NT7S/Si5351AVFO/enclosure/renders/vfo_case_connectors.png

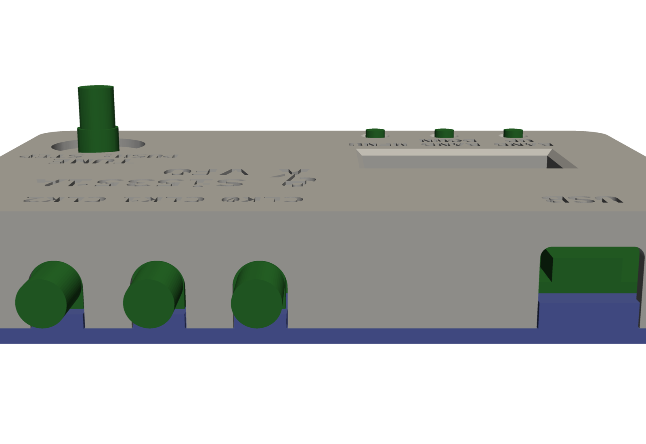
enclosure/renders/vfo_case_connectors.png
