NT7S/Si5351AVFO/enclosure/renders/vfo_case_labels2_front.png

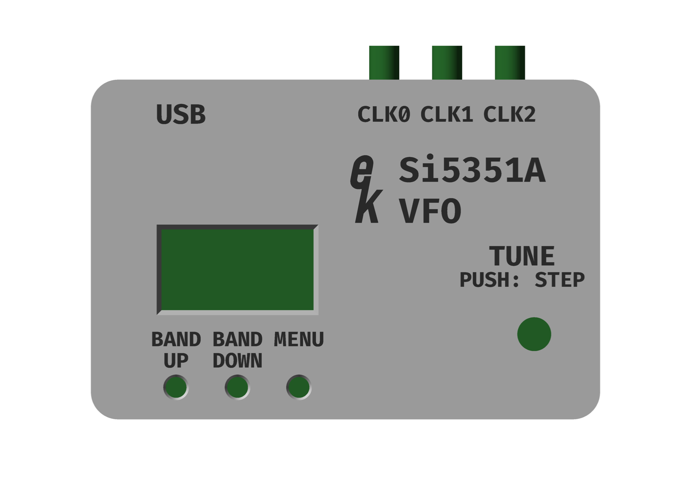
enclosure/renders/vfo_case_labels2_front.png
