NT7S/Si5351AVFO/tools/oledsim/renders/after/main_superhet.png

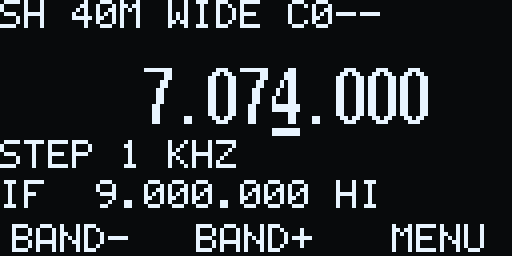
tools/oledsim/renders/after/main_superhet.png
