NT7S/Si5351AVFO/tools/oledsim/renders/after/save_cal.png

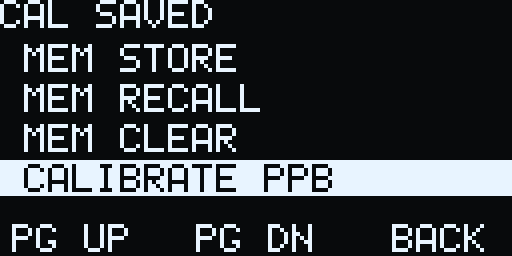
tools/oledsim/renders/after/save_cal.png
