NT7S/Si5351AVFO/tools/oledsim/renders/after/save_filter.png

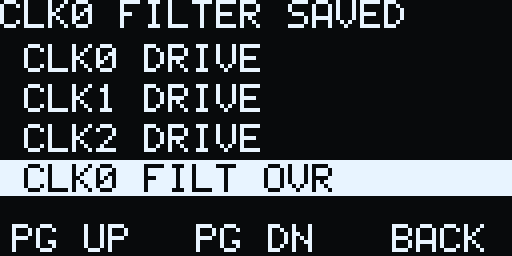
tools/oledsim/renders/after/save_filter.png
