NT7S/Si5351AVFO/tools/oledsim/renders/after/save_inject.png

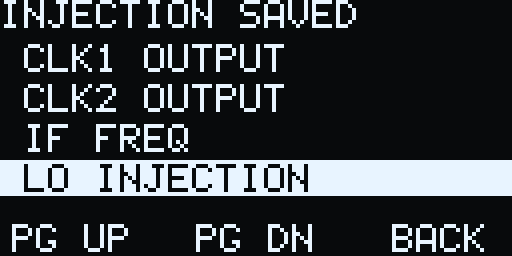
tools/oledsim/renders/after/save_inject.png
