NT7S/Si5351AVFO/tools/oledsim/renders/before/menu_pos_10.png

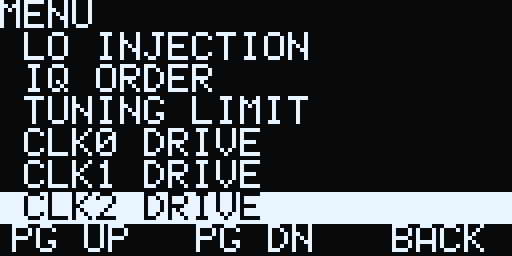
tools/oledsim/renders/before/menu_pos_10.png
