NT7S/Si5351AVFO/tools/oledsim/renders/before/save_clk.png

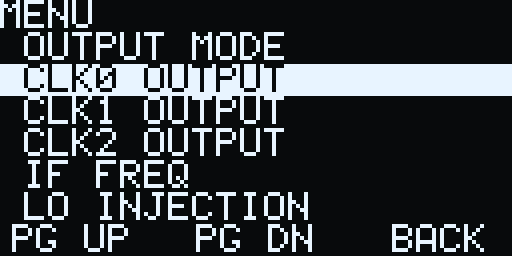
tools/oledsim/renders/before/save_clk.png
