NT7S/Si5351AVFO/tools/oledsim/renders/before/save_drive.png

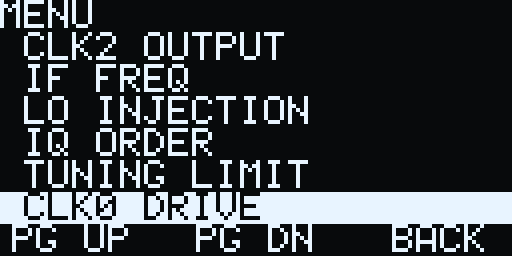
tools/oledsim/renders/before/save_drive.png
