NT7S/Si5351AVFO/tools/oledsim/renders/before/save_filter.png

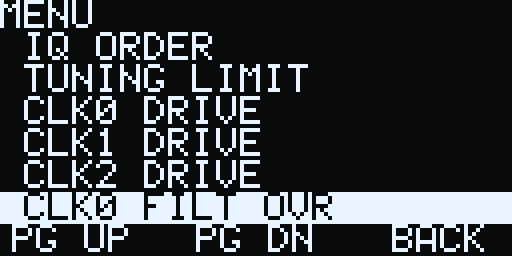
tools/oledsim/renders/before/save_filter.png
