NT7S/Si5351AVFO/tools/oledsim/renders/before/save_if.png

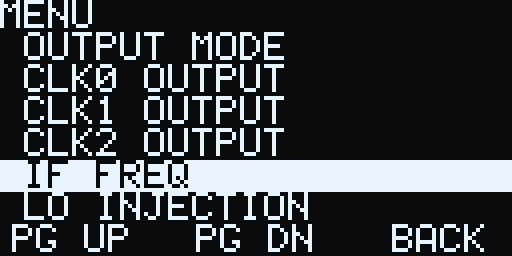
tools/oledsim/renders/before/save_if.png
