NT7S/Si5351AVFO/tools/oledsim/renders/before/save_memory.png

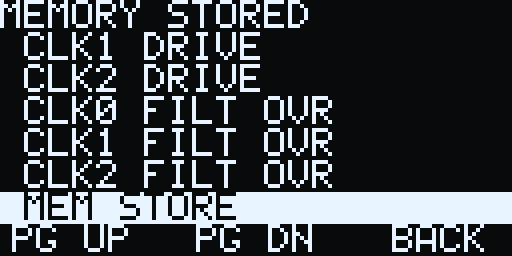
tools/oledsim/renders/before/save_memory.png
