NT7S/Si5351AVFO/tools/oledsim/renders/before/save_mode.png

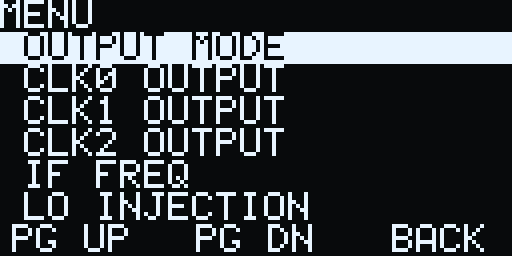
tools/oledsim/renders/before/save_mode.png
