NT7S/Si5351AVFO/tools/oledsim/renders/contact.png

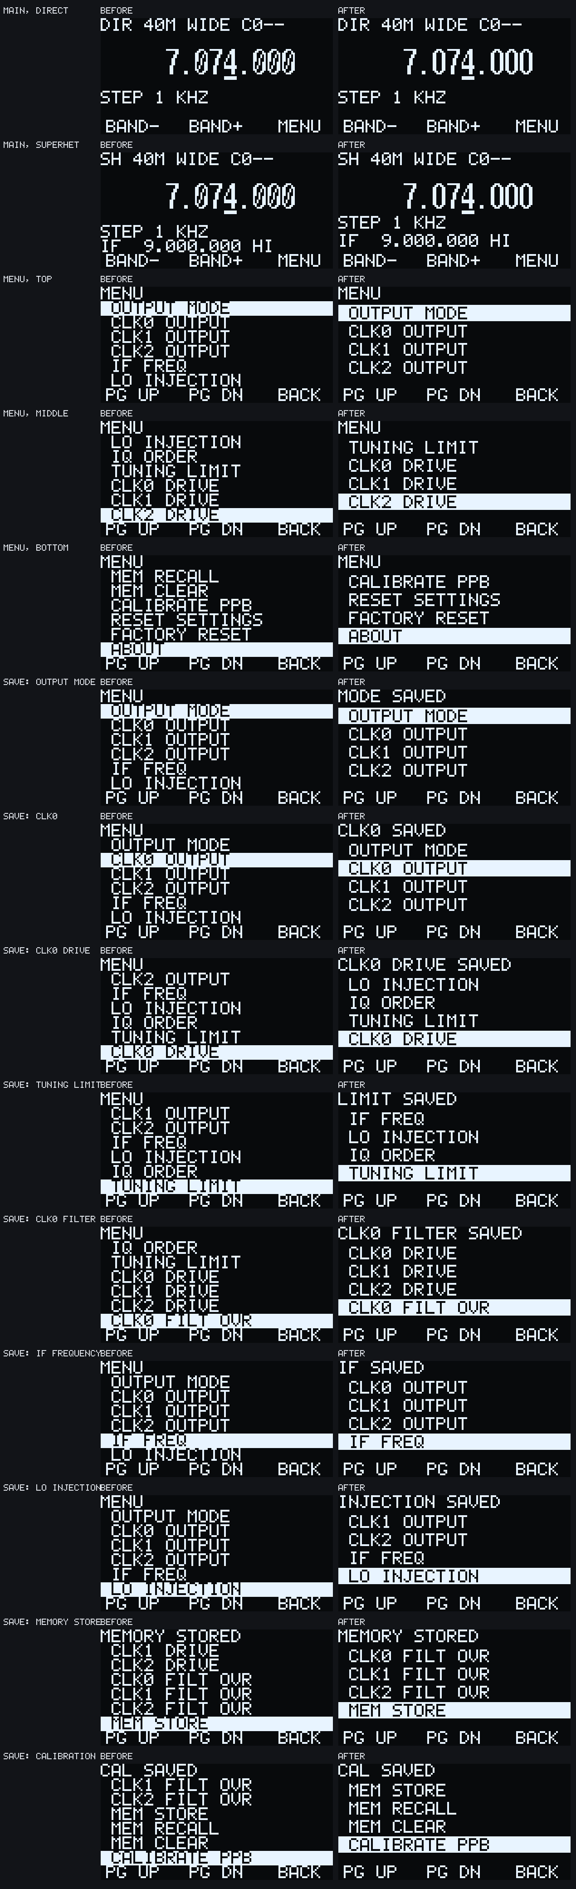
tools/oledsim/renders/contact.png
