NT7S/Si5351AVFO/PCB/production/Si5351AVFO_BOM_JLC.csv

Comment | Designator | Footprint | LCSC Part #
1u | C1,C7 | C_0805_2012Metric | C28323
100n | C2,C4-C6,C8,C14,C15,C17-C21,C25,C28,C100,C120,C140 | C_0805_2012Metric | C49678
4.7u | C3,C9,C16,C22,C23 | C_0805_2012Metric | C1779
100n | C10,C13 | C_0603_1608Metric | C14663
4.7u | C11,C12 | C_0603_1608Metric | C19666
22u | C24 | C_1206_3216Metric | C12891
100n | C26 | C_0402_1005Metric | C1525
10u | C27 | C_0805_2012Metric | C15850
33p | C101,C121 | C_0603_1608Metric | C519485
75p | C102,C122 | C_0603_1608Metric | C519496
82p | C103,C123 | C_0603_1608Metric | C519487
43p | C104,C124 | C_0603_1608Metric | C519493
39p | C105,C125 | C_0603_1608Metric | C527048
20p | C106,C126 | C_0603_1608Metric | C326779
9.1p | C107,C127 | C_0603_1608Metric | C513588
3.6p | C141 | C_0603_1608Metric | C519106
24p | C142 | C_0603_1608Metric | C2857979
30p | C143 | C_0603_1608Metric | C519491
18p | C144 | C_0603_1608Metric | C527046
16p | C145 | C_0603_1608Metric | C519489
5.6p | C146 | C_0603_1608Metric | C519111
2.0p | C147 | C_0603_1608Metric | C513620
SP0503BAHT | D1 | SOT-143 | C7074
1N5711W | D4 | D_SOD-123 | C154843
BLM18PG221 | FB1,FB2 | L_0603_1608Metric | C80165
USB_C_Receptacle | J1 | USB_C_Receptacle_HCTL_HC-TYPE-C-16P-01A | C2894897
UPDI | J5 | PinHeader_1x04_P2.54mm_Vertical | C124378
100n | L1,L4 | L_1008_2520Metric | C1330579
150n | L2,L3,L5,L6 | L_1008_2520Metric | C2044861
33n | L7 | L_1008_2520Metric | C2043161
68n | L8,L9 | L_1008_2520Metric | C703709
5.1k | R1,R2 | R_0603_1608Metric | C23186
10 | R5 | R_0805_2012Metric | C17415
22.1k | R7 | R_0603_1608Metric | C137768
47.5k | R8 | R_0603_1608Metric | C2933225
1k | R9,R29 | R_0603_1608Metric | C21190
10k | R12,R14-R19,R21-R25 | R_0805_2012Metric | C17414
470 | R13 | R_0603_1608Metric | C23179
4.7k | R27,R28 | R_0805_2012Metric | C17673
0 | R100,R120,R140 | R_0402_1005Metric | C17168
EC11E18244A5 | SW1 | RotaryEncoder_Alps_EC11E-Switch_Vertical_H20mm | C255515
SOFT1 | SW2 | SW_Push_6x6mm_SMD_KH-6X6X11H-STM | C2837537
SOFT2 | SW3 | SW_Push_6x6mm_SMD_KH-6X6X11H-STM | C2837537
SOFT3 | SW4 | SW_Push_6x6mm_SMD_KH-6X6X11H-STM | C2837537
LP2985-3.3 | U1,U5 | SOT-23-5 | C16085
Si5351A-B-GT | U2 | MSOP-10_3x3mm_P0.5mm | C529366
CP2102N-A02-GQFN24 | U3 | QFN-24-1EP_4x4mm_P0.5mm_EP2.6x2.6mm | C969151
ATtiny3226-SU | U4 | SOIC-20W_7.5x12.8mm_P1.27mm | C3234898
25MHz TCXO | X1 | Oscillator_SMD_SeikoEpson_SG8002CE-4Pin_3.2x2.5mm | C48888230
