NT7S/Si5351AVFO/enclosure/step/vfo_front_shell_assembly_frame.step

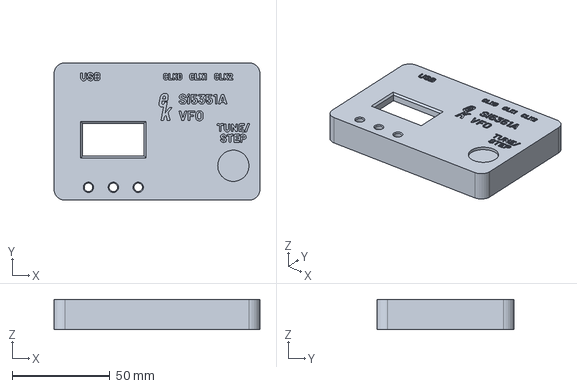
[picture p15: CAD file, 2026-10-25]
enclosure/step/vfo_front_shell_assembly_frame.step
105.2 x 70.2 x 15.4 mm
