NT7S/Si5351AVFO/enclosure/3mf/VFO_case_2color_PETG_CC2_rev4.3mf

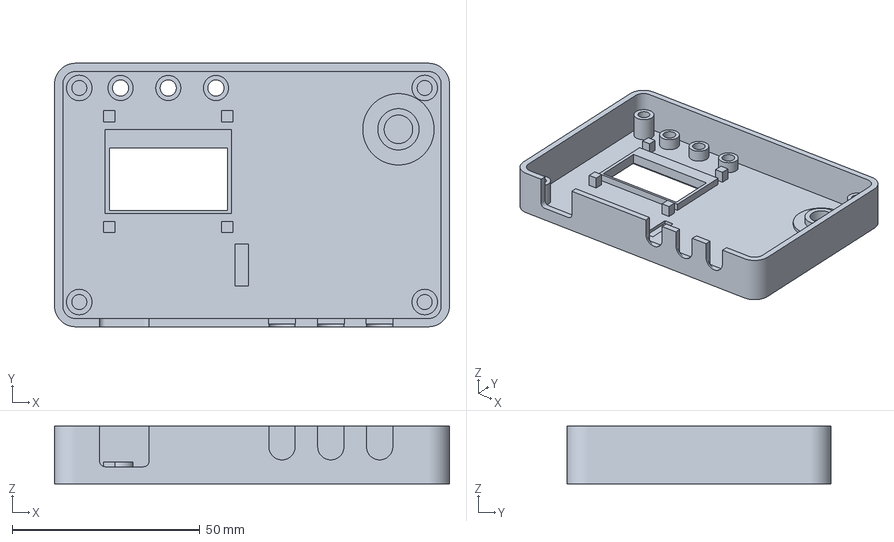
[picture p16: CAD file, 2026-10-25]
enclosure/3mf/VFO_case_2color_PETG_CC2_rev4.3mf
105.2 x 70.2 x 15.4 mm
