NT7S/Si5351AVFO/enclosure/stl/vfo_front_shell_inlay.stl

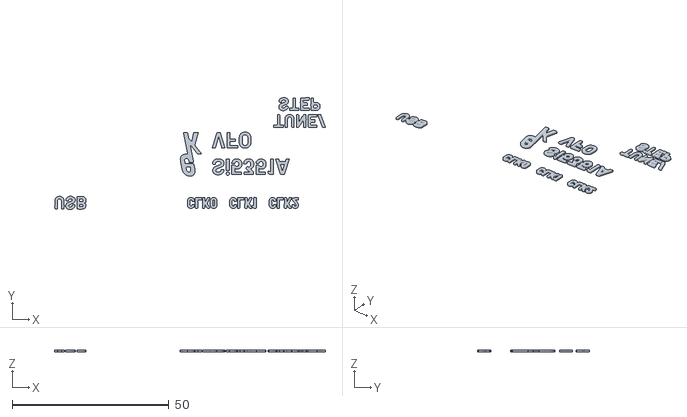
[picture p17: CAD file, 2026-10-25]
enclosure/stl/vfo_front_shell_inlay.stl
86.3 x 35.8 x 0.6
