NT7S/Si5351AVFO/(list of files, cad)

Other CAD files:
enclosure/step/vfo_front_shell_2color.step
enclosure/stl/vfo_front_shell_body.stl
enclosure/step/vfo_front_shell.step
