NT7S/Si5351AVFO/enclosure/renders/vfo_case_cover_print.png

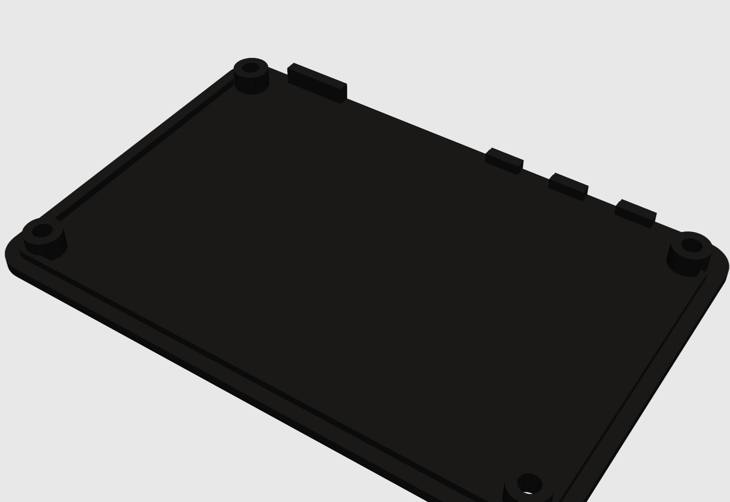
enclosure/renders/vfo_case_cover_print.png
