NT7S/Si5351AVFO/PCB/Si5351AVFO.kicad_pcb

## KiCad design PCB/Si5351AVFO.kicad_pcb (2026-10-28)

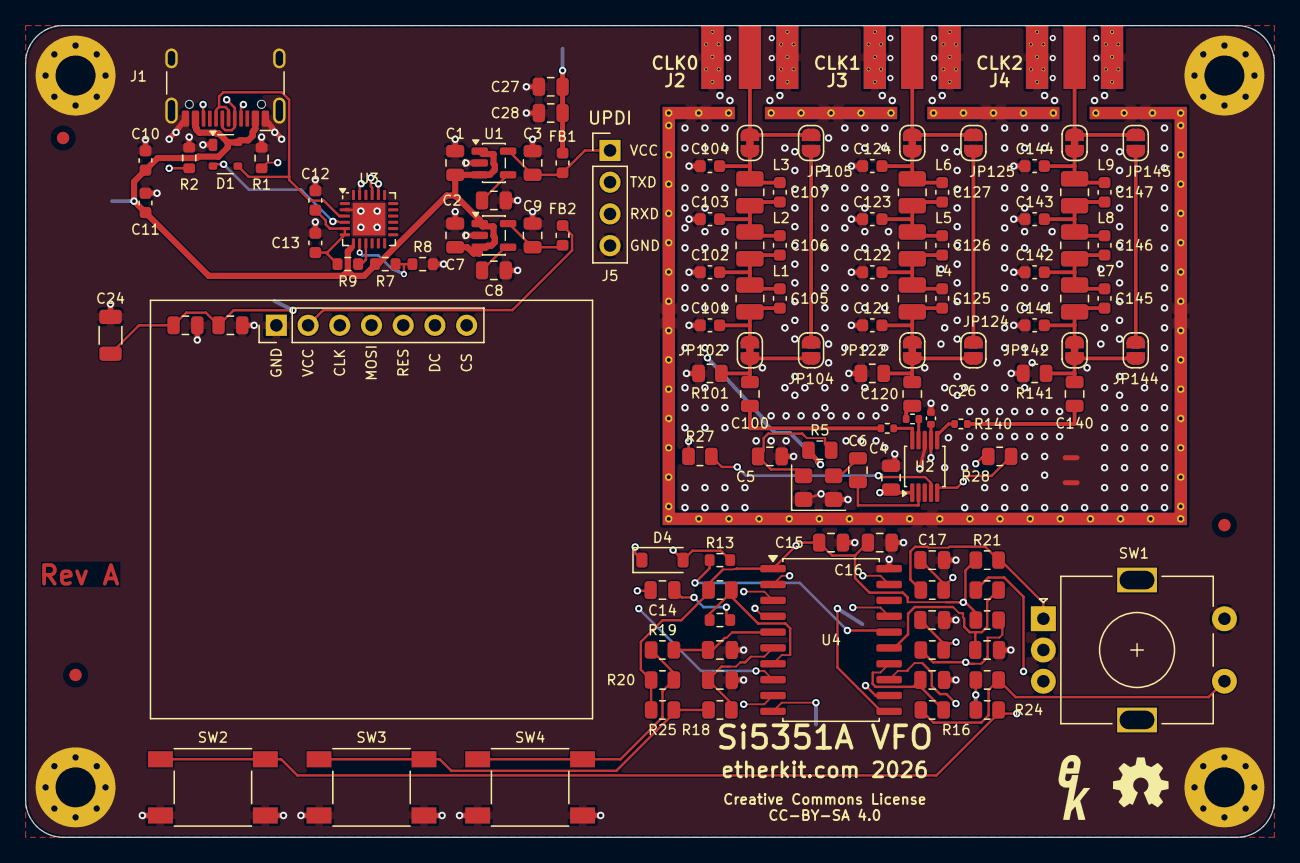
[picture p24: board Si5351AVFO.kicad_pcb from above]

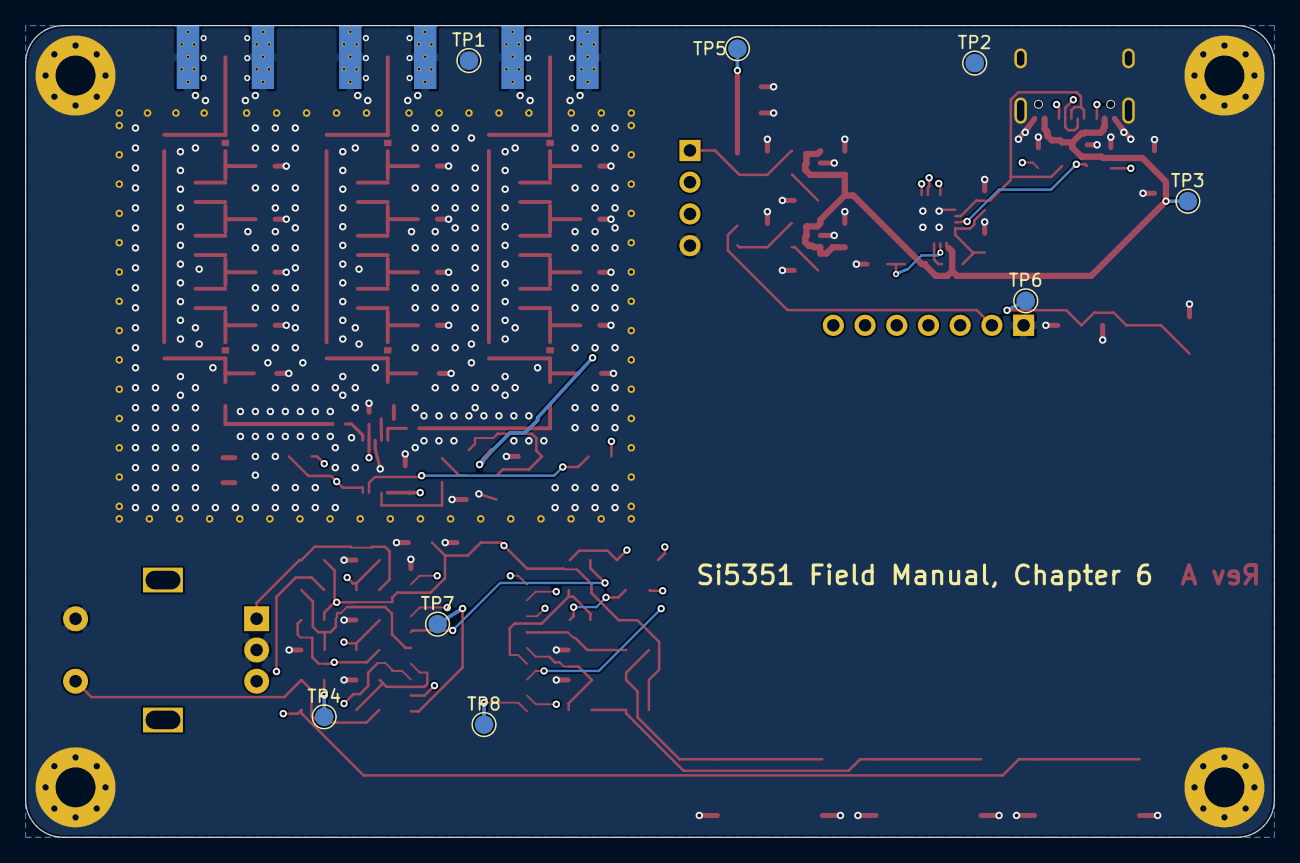
[picture p25: board Si5351AVFO.kicad_pcb from below]

Board: 4 copper layers, 100.0 x 65.0 mm, 140 parts (8 on the bottom side), 72 nets.

Parts:
C1, C7: 1u; C_0805_2012Metric
C2, C4, C5, C6, C8, C14, C15, C17, C18, C19, C20, C21, C25, C28, C100, C120, C140: 100n; C_0805_2012Metric
C3, C9, C16, C22, C23: 4.7u; C_0805_2012Metric
C10, C13: 100n; C_0603_1608Metric
C11, C12: 4.7u; C_0603_1608Metric
C24: 22u; C_1206_3216Metric
C26: 100n; C_0402_1005Metric
C27: 10u; C_0805_2012Metric
C101, C121: 33p; C_0603_1608Metric
C102, C122: 75p; C_0603_1608Metric
C103, C123: 82p; C_0603_1608Metric
C104, C124: 43p; C_0603_1608Metric
C105, C125: 39p; C_0603_1608Metric
C106, C126: 20p; C_0603_1608Metric
C107, C127: 9.1p; C_0603_1608Metric
C141: 3.6p; C_0603_1608Metric
C142: 24p; C_0603_1608Metric
C143: 30p; C_0603_1608Metric
C144: 18p; C_0603_1608Metric
C145: 16p; C_0603_1608Metric
C146: 5.6p; C_0603_1608Metric
C147: 2.0p; C_0603_1608Metric
D1: SP0503BAHT; SOT-143
D4: 1N5711W; D_SOD-123
DS1: OLED_1.3in_SH1106_SPI_7pin; PinHeader_1x07_P2.54mm_Vertical
FB1, FB2: BLM18PG221; L_0603_1608Metric
FID1, FID2, FID3: Fiducial; Fiducial_1mm_Mask2mm
H1, H2, H3, H4: M3; MountingHole_3.2mm_M3_Pad_Via
J1: USB_C_Receptacle; USB_C_Receptacle_HCTL_HC-TYPE-C-16P-01A
J2: SMA CLK0; SMA-ENDLAUNCH
J3: SMA CLK1; SMA-ENDLAUNCH
J4: SMA CLK2; SMA-ENDLAUNCH
J5: UPDI; PinHeader_1x04_P2.54mm_Vertical
JP102, JP103, JP122, JP123, JP142, JP143: NC; SolderJumper-2_P1.3mm_Bridged_RoundedPad1.0x1.5mm
JP104, JP105, JP124, JP125, JP144, JP145: NO; SolderJumper-2_P1.3mm_Open_RoundedPad1.0x1.5mm
L1, L4: 100n; L_1008_2520Metric
L2, L3, L5, L6: 150n; L_1008_2520Metric
L7: 33n; L_1008_2520Metric
L8, L9: 68n; L_1008_2520Metric
LOGO1: Val**; EtherkitLogoSmall
LOGO2: Logo_Open_Hardware_Small; OSHWLogo4mm
R1, R2: 5.1k; R_0603_1608Metric
R5: 10; R_0805_2012Metric
R7: 22.1k; R_0603_1608Metric
R8: 47.5k; R_0603_1608Metric
R9, R29: 1k; R_0603_1608Metric
R12, R14, R15, R16, R17, R18, R19, R20, R21, R22, R23, R24, R25: 10k; R_0805_2012Metric
R13: 470; R_0603_1608Metric
R27, R28: 4.7k; R_0805_2012Metric
R100, R120, R140: 0; R_0402_1005Metric
R101, R121, R141: 120; R_0805_2012Metric
SH1: RF_FENCE; RF_Fence_42x33.5mm
SW1: EC11E18244A5; RotaryEncoder_Alps_EC11E-Switch_Vertical_H20mm
SW2: SOFT1; SW_Push_6x6mm_SMD_KH-6X6X11H-STM
SW3: SOFT2; SW_Push_6x6mm_SMD_KH-6X6X11H-STM
SW4: SOFT3; SW_Push_6x6mm_SMD_KH-6X6X11H-STM
TP1, TP2: GND; TestPoint_Pad_D1.5mm
TP3: +5V; TestPoint_Pad_D1.5mm
TP4: +3V3D; TestPoint_Pad_D1.5mm
TP5: +3V3_CLK; TestPoint_Pad_D1.5mm
TP6: +3V3_OLED; TestPoint_Pad_D1.5mm
TP7: I2C_SCL; TestPoint_Pad_D1.5mm
TP8: I2C_SDA; TestPoint_Pad_D1.5mm
U1, U5: LP2985-3.3; SOT-23-5
U2: Si5351A-B-GT; MSOP-10_3x3mm_P0.5mm
U3: CP2102N-A02-GQFN24; QFN-24-1EP_4x4mm_P0.5mm_EP2.6x2.6mm
U4: ATtiny3226-SU; SOIC-20W_7.5x12.8mm_P1.27mm
X1: 25MHz TCXO; Oscillator_SMD_SeikoEpson_SG8002CE-4Pin_3.2x2.5mm

Connections:
+3V3D: C3.1, C15.1, C16.1, FB1.1, J5.1, R12.1, R20.1, R21.1, R22.1, R23.1, R24.1, R25.1, R27.1, R28.1, TP4.1, U1.5, U4.1
+3V3_CLK: C4.1, C26.1, C27.1, C28.1, FB1.2, R5.1, TP5.1, U2.1, U2.7
+3V3_OLED: C22.1, C23.1, C24.1, DS1.2, FB2.2, TP6.1
+5V: C1.1, C7.1, C10.1, C11.1, D1.4, J1.A4, J1.A9, J1.B4, J1.B9, R7.1, TP3.1, U1.1, U1.3, U3.7, U5.1, U5.3
/MCU and UI/BTN_S1: C20.1, R17.2, U4.15
/MCU and UI/BTN_S1_SW: R17.1, R24.2, SW2.1
/MCU and UI/BTN_S2: C21.1, R18.2, U4.6
/MCU and UI/BTN_S2_SW: R18.1, R25.2, SW3.1
/MCU and UI/BTN_S3: C25.1, R19.2, U4.5
/MCU and UI/BTN_S3_SW: R19.1, R20.2, SW4.1
/MCU and UI/ENC_A: C17.1, R14.2, U4.12
/MCU and UI/ENC_A_SW: R14.1, R21.2, SW1.A
/MCU and UI/ENC_B: C18.1, R15.2, U4.13
/MCU and UI/ENC_B_SW: R15.1, R22.2, SW1.B
/MCU and UI/ENC_SW: C19.1, R16.2, U4.14
/MCU and UI/ENC_SW_SW: R16.1, R23.2, SW1.S1
/MCU and UI/OLED_CS: DS1.7, U4.2
/MCU and UI/OLED_DC: DS1.6, U4.3
/MCU and UI/OLED_MOSI: DS1.4, U4.17
/MCU and UI/OLED_RES: DS1.5, U4.4
/MCU and UI/OLED_SCK: DS1.3, U4.19
/MCU and UI/UPDI_PA0: R13.1, U4.16
/MCU and UI/UPDI_TXD: D4.1, J5.2
/Power and USB/CP_RST: R9.2, U3.9
/Power and USB/CP_VBUS_SENSE: R7.2, R8.1, U3.8
/Power and USB/CP_VDD: C12.1, C13.1, R9.1, U3.5, U3.6
/Power and USB/USB_DM: D1.2, J1.A7, J1.B7, U3.4
/Power and USB/USB_DP: D1.3, J1.A6, J1.B6, U3.3
/Synth and RF outputs/CLK0: R100.1, U2.10
/Synth and RF outputs/CLK0_BYP: JP104.2, JP105.1
/Synth and RF outputs/CLK1: R120.1, U2.9
/Synth and RF outputs/CLK1_BYP: JP124.2, JP125.1
/Synth and RF outputs/CLK2: R140.1, U2.6
/Synth and RF outputs/CLK2_BYP: JP144.2, JP145.1
DTR: C14.1, U3.23
GND: C1.2, C2.2, C3.2, C4.2, C5.2, C7.2, C8.2, C9.2, C10.2, C11.2, C12.2, C13.2, C15.2, C16.2, C17.2, C18.2, C19.2, C20.2, C21.2, C22.2, C23.2, C24.2, C25.2, C26.2, C27.2, C28.2, C101.2, C102.2, C103.2, C104.2, C121.2, C122.2, C123.2, C124.2, C141.2, C142.2, C143.2, C144.2, D1.1, DS1.1, H1.1, H2.1, H3.1, H4.1, J1.A1, J1.A12, J1.B1, J1.B12, J1.SH, J2.2, J3.2, J4.2, J5.4, R1.2, R2.2, R8.2, R101.2, R121.2, R141.2, SH1.1, SW1.C, SW1.S2, SW2.2, SW3.2, SW4.2, TP1.1, TP2.1, U1.2, U2.8, U3.2, U3.25, U4.20, U5.2, X1.1, X1.2
I2C_SCL: R27.2, TP7.1, U2.4, U4.11
I2C_SDA: R28.2, TP8.1, U2.5, U4.10
MCU_RX: U3.21, U4.8
MCU_TX: U3.20, U4.9
unnamed: C14.2, R29.2
unnamed: C100.1, R100.2
unnamed: C102.1, C105.2, C106.1, L1.2, L2.1
unnamed: C103.1, C106.2, C107.1, L2.2, L3.1
unnamed: C120.1, R120.2
unnamed: C122.1, C125.2, C126.1, L4.2, L5.1
unnamed: C123.1, C126.2, C127.1, L5.2, L6.1
unnamed: C140.1, R140.2
unnamed: C142.1, C145.2, C146.1, L7.2, L8.1
unnamed: C143.1, C146.2, C147.1, L8.2, L9.1
unnamed: D4.2, J5.3, R13.2
unnamed: J1.A5, R1.1
unnamed: J1.B5, R2.1
unnamed: J2.1, JP103.2, JP105.2
unnamed: J3.1, JP123.2, JP125.2
unnamed: J4.1, JP143.2, JP145.2
unnamed: C100.2, JP102.1, JP104.1, R101.1
unnamed: C101.1, C105.1, JP102.2, L1.1
unnamed: C104.1, C107.2, JP103.1, L3.2
unnamed: C120.2, JP122.1, JP124.1, R121.1
unnamed: C121.1, C125.1, JP122.2, L4.1
unnamed: C124.1, C127.2, JP123.1, L6.2
unnamed: C140.2, JP142.1, JP144.1, R141.1
unnamed: C141.1, C145.1, JP142.2, L7.1
unnamed: C144.1, C147.2, JP143.1, L9.2
unnamed: C2.1, U1.4
unnamed: C6.2, U2.2
unnamed: R12.2, R29.1, U4.7
unnamed: C8.1, U5.4
unnamed: C9.1, FB2.1, U5.5
unnamed: C6.1, X1.3
unnamed: C5.1, R5.2, X1.4
