NT7S/Si5351AVFO/(commit log)

2026-10-23 Rev A schematic draft: hierarchical sheets (power/USB, MCU/UI, synth/RF), ERC clean, VERIFY list
2026-10-23 UPDI: replicate EtherKeyerMini UPDI circuit (J5/R13/D4/D5/JP1/JP2); remove CP2102N LEDs D2/D3 + R10/R11, NC pins 13/14
2026-10-23 Wire local connections (labels only for long/cross-sheet runs); +3V3_MCU diode-OR rail (D6/D5); drop UPDI JP1/JP2; fix C14 fields
2026-10-23 Drop +3V3_MCU/D5/D6: U4 and pull-ups back on +3V3D; J5 pin 1 = +3V3D VCC reference (USB-powered programming)
2026-10-23 synth_rf: populate Cauer LPFs (CLK0/1 60 MHz, CLK2 160 MHz) with LCSC parts; replace 0R filter links with solder jumpers (JP1x2/JP1x3 NC in-line, JP1x4 NO bypass); interchangeability note
2026-10-24 Schematic: US resistor symbols, decoupling caps at their ICs, drop finalized VERIFY notes
    - Device:R_Small -> Device:R_Small_US on all 30 resistors (same pin geometry; refs/values/fields/footprints/LCSC unchanged)
    - Move label-connected decoupling caps next to their ICs: C10/C11 + C12/C13 at U3, C15/C16 at U4, C4 at U2
    - Add PCB placement notes by U1, U5, U3, U4, U2/X1 and DS1 (pins from netlist)
    - Remove VERIFY note lines and VERIFY fields for items Jason finalized:
    J1 D1 C10 U3 FB2 DS1 C17 SW1 X1 C100 R101 L1 C105
    - Netlist identical to 4963a6d; ERC 0 errors
2026-10-24 Add KiCad .gitignore, untrack lock/autosave/backup files, add tools/export_docs.sh, regenerate docs
2026-10-24 Add GitHub Action: ERC (fail on errors) and auto-regenerate docs on schematic changes
2026-10-24 docs: regenerate schematic PDF, netlist, SVGs, ERC report [skip ci]
2026-10-24 CI: use kicad/kicad:10.0-full (stock libs) and ignore netlist source path
2026-10-24 CI: install default KiCad lib tables so stock libraries resolve
2026-10-24 Resolve VERIFY directives: R9 to VIO, R29 on PB4, OLED bulk, SMD UPDI parts, 4.7k I2C, 0805 0R, Etherkit SMA footprint
    - R9 /RST pull-up moved from +5V to CP_VDD (CP2102N DS 2.1, Table 3.10)
    - New R29 1k (C21190) between C14 and PB4 to limit DTR-rise injection current (ATtiny3226 DS Table 33-1)
    - C24 fitted 22u 1206 (C12891); C22/C23 kept 2x4.7u
    - R13 0603 C23179, D4 1N5711W SOD-123 C154843, J5 1x4 pin header C124378
    - R27/R28 4.7k C17673; R100/R120/R140 0805 0R C17477; R101/R121/R141 LCSC C17437 (DNP)
    - J2-J4 footprint EtherkitKicadLibrary:SMA-ENDLAUNCH
    - H1-H4 and solder jumpers excluded from BOM
    - Finalized VERIFY notes removed from sheets; VERIFY.md items ticked with KiCad EE notes
2026-10-24 docs: regenerate schematic PDF, netlist, SVGs, ERC report
2026-10-24 DS1 OLED: DNP user-fitted (partial kit), no LCSC, off BOM/pos; keep 3.3V LP2985 rail; silkscreen pin-name note; VERIFY DS1 supply resolved; regen docs
2026-10-24 DS1: generic 1.3in SH1106 SPI 7-pin (GND,VCC,CLK,MOSI,RES,DC,CS); OLED_RES on PA6, PA2 freed; remove R26/FS0/CS2; DNP supplied in kit; VERIFY + regen docs
2026-10-24 Retire schgen generator (kicad_sch files are master); drop unverified Adafruit note
2026-10-24 J2-J4 SMA: DNP, supplied in kit, user-soldered; off BOM/pos, LCSC cleared, MPN kept; VERIFY + regen docs
2026-10-24 PCB phase 1: footprints from schematic, JLC04161H-7628 4-layer stackup (blue mask), RF50 netclass 0.35 mm, 100x65 outline + 4x M3, edge/panel part placement, OLED keepout, rough placement (unrouted);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
2026-10-24 SW2-SW4: 6x6 mm 11 mm-tall SMD tact switch KH-6X6X11H-STM (C2837537) for front panel
2026-10-24 H1-H4: plated M3 mounting holes (MountingHole_3.2mm_M3_Pad_Via) tied to GND
2026-10-24 SH1: DNP RF shield solder fence (GND), OSHW logo footprint
2026-10-24 Layout rev 2: USB-C + SMAs on top edge, RF block under SH1 fence, 11 mm tact switches, plated GND M3 holes, In1 cut under SMA centre pads, In1/In2 GND planes, Etherkit branding + Rev A on F.Cu; regen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
2026-10-24 Layout: buttons back in a row under OLED (OLED moved up), Si5351 decoupling at U2/X1 pins, power/USB tidied (LDO rows Cin-U-Cout-FB), CLK0-2 labels, horizontal front branding, back-silk book line, si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
2026-10-24 Layout: straight-line LPF per channel (in-select -> 3-section Cauer ladder -> out-select -> SMA), bypass jumper at input end behind GND via fence; J5 UPDI title + pin labels
2026-10-24 Route RF: CLK0-2 0.35 mm CPWG (gap 0.20) through series R, DC block, select jumpers, Cauer LPF, bypass lane to SMAs; GND vias at all SMD GND pads; RF stitching; F/B GND pours
2026-10-24 PCB: re-place MCU area (U4 rot 0, passives by pin side); freerouted power+digital (WIP, 26 unconnected); Alps EC11E18244A5 model for SW1; regen board STEP
2026-10-24 PCB: route power nets (USB VBUS, LDOs, +5V/+3V3 rails) via freerouting; add tools/pcbgen build scripts; U3 EP vias; OLED-area F.Cu track keepout
2026-10-24 PCB: route digital nets (CP2102N, ATtiny, OLED SPI, buttons/encoder, I2C, UPDI); DRC 0 unconnected
2026-10-24 Add 3D-printed enclosure (first iteration)
    CadQuery source, STL/STEP/3MF exports, renders and README for a
    two-part supportless case for the Si5351A VFO board. Pending fit check.
2026-10-24 U2 decoupling: C26 100n at VDDO (pin 7), C27 10u + C28 100n bulk on +3V3_CLK after FB1, caps inline at the U2 supply pins; RF50 netclass (0.31 mm) incl. CLK0-2_BYP lanes; regen docs
2026-10-24 R100/R120/R140 -> 0402 0R (C17168) and C26 -> 0402 100n (C1525) so the series R and VDDO cap fit at U2's 0.5 mm-pitch CLK/VDDO pins; regen docs
2026-10-24 Sync schematic from rev-a-schematic (24008ef): C26/C27/C28 U2 decoupling, 0402 CLK series Rs, RF50 incl. CLK*_BYP; regen docs
2026-10-24 Soft buttons: BTN_BAND/STEP/MENU -> BTN_S1/S2/S3 (left to right), SW2-SW4 values SOFT1-SOFT3 (labels drawn on the OLED); regen docs, ERC 0
2026-10-24 Sync schematic from rev-a-schematic (a9b48d3): soft-button nets BTN_S1-S3, SW2-SW4 SOFT1-3; regen docs
2026-10-24 WIP: partial PCB review fixes (interrupted pass)
2026-10-24 PCB: C27 10u/C28 100n at FB1 output (+3V3_CLK), reroute +3V3_CLK FB1->U2 on In2/B.Cu; C26 at VDDO pin 7, C4 at VDD pin 1
2026-10-24 PCB: connect CP_VBUS_SENSE (U3.8) via B.Cu hop, tighten CP_RST escape; DRC 0 unconnected, 0 clearance
2026-10-24 DRC: enforce 0.20 mm CPWG gap RF50<->GND pour (verified 68/68 RF tracks at 0.20-0.21 mm, all RF lanes 0.31 mm except 0.25 mm U2 pin breakouts)
2026-10-24 PCB: GND stitching - 18 vias (0.5/0.25) flanking each SMA launch cutout, 20 vias closing >2.2 mm gaps on filter fence lines
2026-10-24 PCB silk nits: C4 0.3 mm off U2 (no silk overlap), C27/C28 mirrored west of +3V3_CLK trunk clear of UPDI legend; DRC: only SMA edge-launch hits
2026-10-24 tools/pcbgen: sync current layout scripts from build (gen_pcb placements, models, router/stitch helpers, fr.ses); document hand-fix caveat
2026-10-24 3D: simple open-top RF fence/can model for SH1 (42x33.5x3 mm, 0.25 mm wall); DRC unchanged
2026-10-24 Silkscreen: J2/J3/J4 refs on F.Silk under CLK0/1/2 labels, consistent style
2026-10-25 firmware: fix Test Lab F1/F2 and resolve rev 3.2 spec ambiguities
    - Band change sets clock enables per mode (4 m/2 m Direct/IQ -> CLK2, CLK0/1
    kept only if overridden; restore CLK0 when returning to HF)
    - Per-band last-used F tracked on every in-band change and in deferred save;
    off-band F never overwrites it
    - IQ floor 4761905 Hz (600 MHz/126), UI text 4.76 MHz
    - Amateur-only: F inside another band switches band; LIMIT HAM while off-band
    goes to nearest band edge (vfo_set_limit)
    - Serial: 'F ?' is a query, '?' only on query commands (else ERR CMD), exact
    arg counts (extra -> ERR ARG), BAND 40 shorthand, IF range 8 kHz-160 MHz
2026-10-25 firmware: apply band-change clock-enable rule on every band-index change
    Centralize in set_band_index(), used by BAND/band step, F into another band,
    encoder tuning across bands, MR recall and LIMIT HAM edge moves. Nearest-edge
    tie goes to the lower-frequency band (REQUIREMENTS rev 3.3).
2026-10-25 firmware: independent review fixes (rev 3.4)
    B1 re-apply output enables after quadrature/set_freq programming
    B2 cal editor: hardware-only preview, restore on cancel, save on confirm
    S1 EEPROM A/B slots with sequence counter + CRC per slot (layout v2)
    S2 quadrature capped at 90 MHz (divider >= 10), PLAN_IQ_HIGH
    S3 library return codes checked; refused clock off + PLAN_FAIL message
    S4 quadrature skipped in menu / MODE IQ -> ERR IQRANGE out of range
    S5 clock-enable rule on mode changes; MR applies recalled mode then band
    S6 CAL range +/-999999 ppb (serial, EEPROM); S7 encoder/edit overflow clamps
    S8 vfo_begin resets hw caches; S10 Reset settings vs Factory reset,
    serial RESET / RESET ALL. Nits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
2026-10-25 F1: in quadrature, CLK0/CLK1 power-up forces a full pair reprogram (phase + PLLA reset)
2026-10-25 Enclosure rev4: soft keys, Barlow inlay text, TUNE/STEP label
    - Remove the BAND UP / BAND DOWN / MENU labels; the buttons are now
    display soft keys.
    - Panel graphics are a flush two-color inlay. Text uses Barlow Bold,
    with Barlow Semi Condensed Bold for the CLK0/1/2 row so the labels
    no longer run together. Strokes under 0.8 mm are widened.
    - Encoder label is "TUNE/" over "STEP", centered on the shaft and
    raised to clear a 20 mm knob.
    - Bundle the Barlow fonts with the SIL OFL notice and load them, and
    the board STEP, by paths relative to the scripts.
    - Add two-color STEP/STL exports, the rev4 OrcaSlicer 3MF and the
    printed Centauri Carbon 2 G-code. Update the README.
2026-10-25 Test points TP1-TP8 (GND x2, +5V, +3V3D, +3V3_CLK, +3V3_OLED, I2C_SCL/SDA) on B.Cu, 1.5 mm SMD, excluded from BOM/CPL; no RF nets. JLC fab outputs (tools/export_fab.sh -> PCB/production). ERC 0, DRC 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
2026-10-25 Basic-part swaps: C11/C12 C1705->C19666 (CL10A475KO8NNNC 16V), R1/R2 C105580->C23186 (0603WAF5101T5E). Board fields synced, ERC 0, DRC 15 accepted SMA hits, fab outputs + schematic PDF regenerated
2026-10-25 Fix annotation errors: duplicate GND power refs #PWR900-903 in power_usb second set renamed #PWR920-923 (property + instance reference). Netlist export clean, ERC 0, DRC 15 accepted SMA hits, BOM/CPL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
2026-10-25 Enclosure: regenerate renders from rev4
    render.py now draws the two-color front shell (black body, white inlay) and writes straight into enclosure/renders/. All eight renders are regenerated from rev4: soft-key buttons with no labels, Barlow text, and the two-line TUNE/STEP encoder label. Drop the README note that the renders were stale.
2026-10-25 X1 TCXO pin 1 (NC/EN) tied to GND, R6 (VDD->pin 1) removed; same fix as OpenBeacon2 2de6f2e. PCB: R6 footprint and its VDD stub removed, X1.1 to GND via under X1, zones refilled. ERC 0, DRC 15 accept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
2026-10-27 Separate the SH1106 menu and superhet rows, and confirm saves.
    The menu filled every page, so the selection bar met the row above it and the key labels. Four rows at a 10 px pitch leave a gap around the bar and a blank page above the labels, and all 21 items still scroll. Superhet draws the step and IF lines with a gap between them and above the key labels. The big-digit zero is an open oval with the same stroke as the other digits. Every editor that writes a setting reuses the info-line confirmation.
2026-10-27 Pad the menu highlight and record the current firmware size.
    The inverted bar is 9 px, one pixel above and below the 7 px glyphs, so the letters no longer sit on its edge. The 10 px row pitch is unchanged, which leaves a 1 px gap between bars and rows 49-55 blank above the key labels. The README size row matches this ATtiny3226 build: 29,280 B flash, 662 B RAM.
2026-10-28 Regenerate JLC BOM, netlist and schematic PDF for U2 LCSC C529366
