NT7S/Si5351AVFO/(notices)

Notices in the files:
PCB/Si5351AVFO.kicad_pcb:
Creative Commons License
CC-BY-SA 4.0
